nielu/FUSS/docs/prezentacja_seminarium.pptx

## System monitorowania domu z wykorzystaniem układów ESP8266 i platformy dla systemów wbudowanych Raspberry Pi

Jan Nielek

## Informacje

- Temat: System monitorowania domu z wykorzystaniem układów ESP8266 i platformy dla systemów wbudowanych Raspberry Pi
- Wykonawca: Jan Nielek
- Promotor: dr. Krzysztof Bikonis
- Katedra: Katedra Systemów Geoinformatycznych

## Problem

- Dom w „głuszy”, niepewne ogrzewanie
- Awaria ogrzewania może skutkować uszkodzeniem systemów CO i sanitarnego

## Pomysł

- Uruchomiony stały dostęp do Internetu za pośrednictwem telefonii LTE
- Gotowe rozwiązania obecne na rynku wydawały się zbyt drogie jak na proponowaną funkcjonalność
- Na szybko powstał PoC rozwiązania wykorzystującego ESP8266 i chmurę ThingsSpeak
- Wykorzystanie własnego serwera daje większe możliwości

## Projekt

## Architektura

- Niezależne sensory wykorzystujące istniejącą sieć WiFi
- Serwer znajdujący się w osobnej sieci
- Komunikacja z wykorzystaniem protokołu MQTT
- Interakcja z użytkownikiem poprzez interfejs WWW
- Odczyty zapisywane w bazie danych

temperatura

wilgotność

serwer

DB

## Dlaczego WiFi?

Za

ZigBee:
Energooszczędne, daleki zasięg
Bluetooth:
Energooszczędne, tanie mikroprocesory
WiFi:
Istniejąca już infrastruktura, tanie mirkoprocesory

Popularne na rynku:
- ZigBee
- Bluetooth
- WiFi

Przeciw

ZigBee:
Drogie, wymaga tunelowania do sieci IP
Bluetooth:
Mały zasięg, wymóg tunelowania
WiFi:
Wysokie zapotrzebowanie na energię

## Dlaczego MQTT?

Za

REST:
Prosta implementacja po stronie serwera
Własna implementacja:
Dopasowanie do architektury, wysoka wydajność, energooszczędność
MQTT:
Gotowe biblioteki dla uC, rozwiązanie dominujące w IoT

Przeciw

REST:
Nadmiernie obciąża uC, dużo niepotrzebnych informacji
Własna implementacja:
Czas potrzebny na zaprojektowanie i zaimplementowanie, brak rozszerzalności
MQTT:
Potrzebny zewnętrzny broker (serwer)

Popularne na rynku:
- Interfejsy HTTP (REST)
- Implementacja własnego protokołu
- MQTT

## Sensor temperatury i wilgotności

Założenia projektowe:
Jak najdłuższy czas pracy na baterii
Wbudowany układ ładowania
Prosty w montażu (nie SMD)

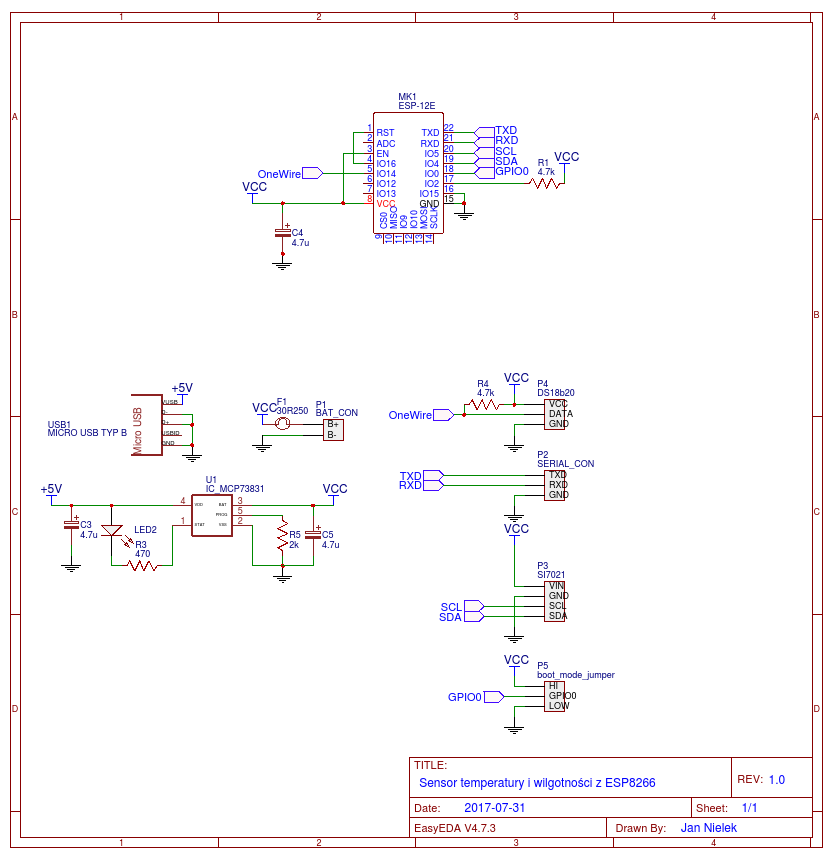
[picture p1: figure]

## Produkcja prototypu

- Projekt PCB

- Wykonanie

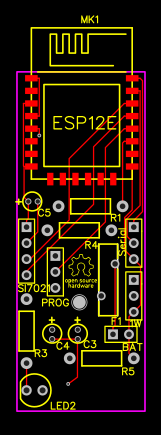
[picture p2: figure]
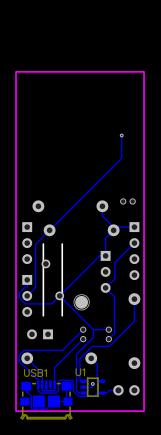
[picture p3: figure]
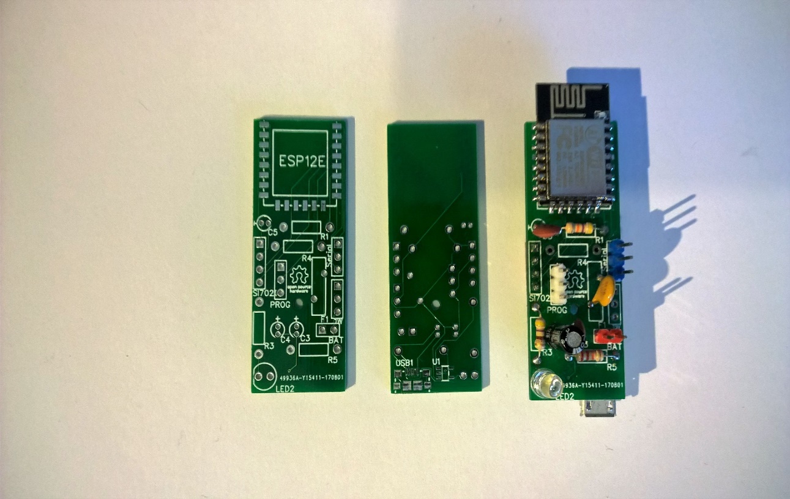
[picture p4: figure]

## Serwer - implementacja

- Aplikacje wspierające

- System operacyjny: Raspian (dystrybucja Linuxa oparta o Debiana)
- Baza danych: MySQL
- Broker MQTT: Mosquitto

- Serwer

- Backend napisany w Pythonie
  - Framework Flask
  - Liczne dodatkowe biblioteki (bcrypt, mosquitto, SQLAlchemy)
- Frontend: HTML + CSS + js
  - Framework(?): Bootstrap
  - Wykresy z wykorzystaniem Highcharts.js

## Wyświetlanie pomiarów

Biblioteka Highcharts.js
- Asynchroniczne ładowanie danych (jQuery)
- Renderowanie odbywa się po stronie użytkownika
- W chwili obecnej ok. 140 tysięcy punktów

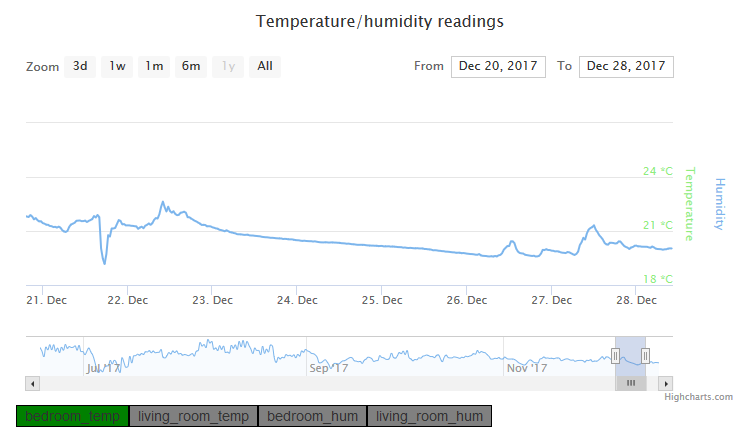
[picture p5: figure]

## Narzędzia pracy

- Schemat ideowy, projekt i wykonanie PCB: easyEDA.com
- Testowanie prototypu: multimetr UNI-T UT58C, oscyloskop DSO-2090

- IDE: Visual Studio (jedna solucja dla serwera i uC)
- VCS: git (repozytorium na github.com)

## Testowanie

- Serwer testowany „na bieżąco”
- Słaba znajomość pythona = brak unit testów i bałagan w kodzie

- Prototyp płytki drukowanej działa bez zarzutów
- Osiągnięto półroczny czas pracy na jednym ładowaniu

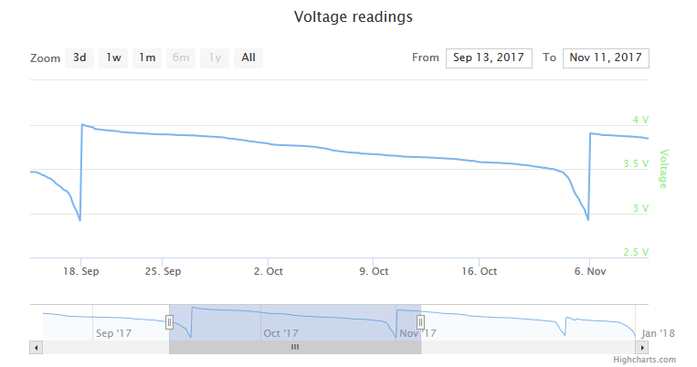
[picture p6: figure]

## Wyniki

- Małoseryjna produkcja nie jest opłacalna (gotowe rozwiązania można kupić za 10% ceny samych materiałów sensora zaprezentowanego w pracy)
- Pomimo obaw o zapotrzebowanie na energię, umiejętne zastosowanie uśpienia w uC pozwala uzyskać długi czas pracy.

## Pytania
