nielu/FUSS/(commit log)

2017-06-07 init device blueprints
2017-06-07 moved devices to external modules Now every device has to implement blueprint
2017-06-08 Revert "init device blueprints"
    This reverts commit cfcf5ea8afd98d30cf173b314248bc09e675e9c5.
2017-06-08 refactored devices
2017-06-08 add interaction to devices moved device templates
2017-06-28 MAJOR redesign Switch DB provider to MySQL via SQLAlchemy Switch device communication to MQTT protocol Cleanup in app web UI Cleanup in code Add modularity - now backend code for devices can be split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
2017-07-04 fix for typo in comments
    [MCP9808.ino, SI7021.ino]
2017-07-04 refactored device modules to account for gaps in readings
2017-08-10 Switched to highchars and backend json for large graphs Added admin panel Added sensor telemetry (WIP)
2017-08-10 add fancy button coloring
2017-08-20 Add SMSAPI POC, changed show_all graph to render points using date from DB removed unused code from MCP9808 and SI7021 device modules
2017-08-23 Unified sensor for JSON messages Add sensor telemetry
2017-08-23 Changed device fw to send readings and telemetry in JSON
2018-01-04 add voltage monitoring
